OlexiyOdarchuk/ajax-final-project/case/expansion_board.step

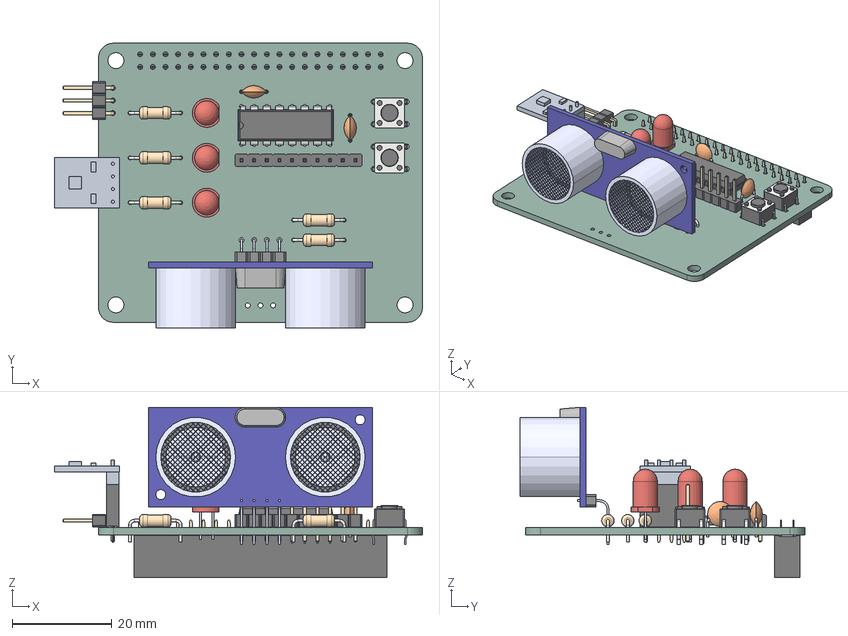
[picture p1: CAD file, 2026-10-27]
case/expansion_board.step
73.8 x 57.1 x 34.2 mm
R_Axial_DIN0207_L63mm_D25mm_P1016mm_Horizontal x 5
SW_PUSH_6mm x 2
LED_D5.0mm x 3
PinHeader_1x10_P254mm_Vertical
C_Disc_D50mm_W25mm_P500mm x 2
PinSocket_1x04_P2.54mm_Vertical
DIP-16_W7.62mm
HC-SR04
PinHeader_1x03_P254mm_Horizontal
PinSocket_2x20_P2.54mm_Vertical
rpi_PCB
