OlexiyOdarchuk/ajax-final-project/case/stl/case_lid.stl

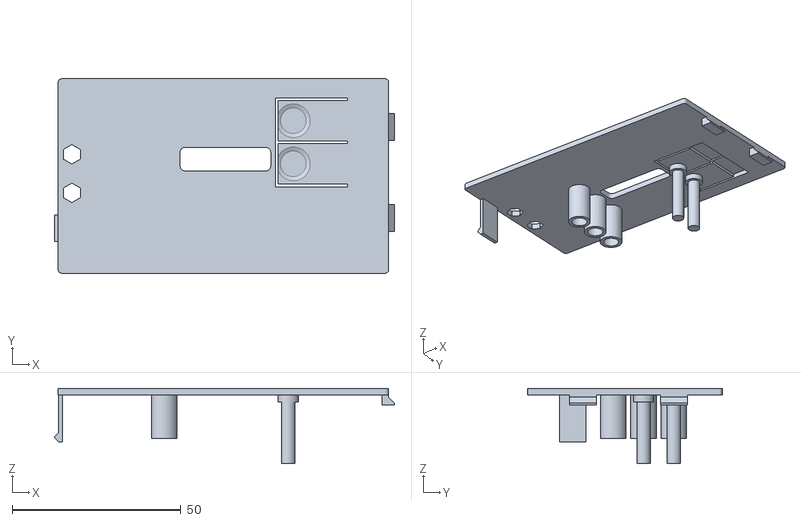
[picture p2: CAD file, 2026-10-06]
case/stl/case_lid.stl
100.9 x 57.7 x 22.4
