OlexiyOdarchuk/ajax-final-project/case/gateway_case.FCStd

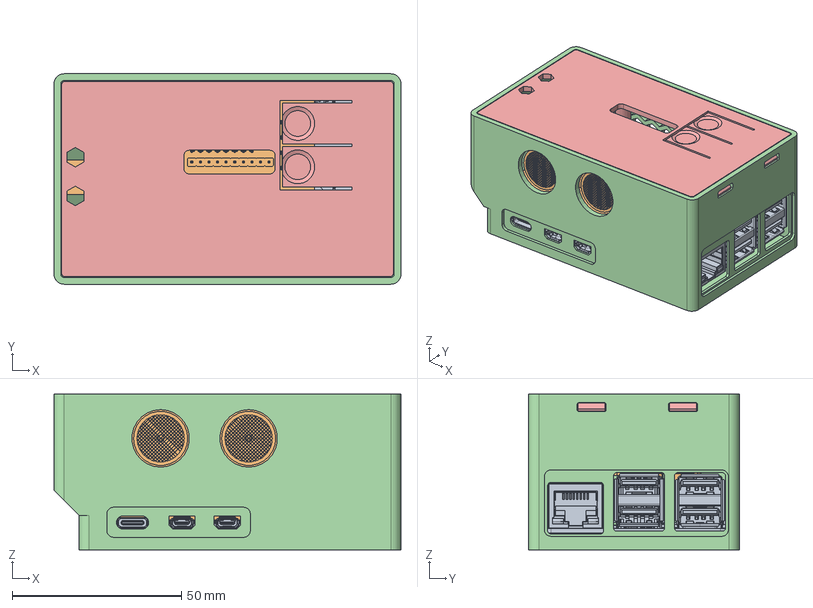
[picture p3: CAD file, 2026-10-27]
case/gateway_case.FCStd
102.5 x 62.2 x 46.0 mm
RaspberryPi5
ExpansionBoard
Standoffs
CaseBody
CaseLid
