OlexiyOdarchuk/ajax-final-project/case/stl/case_body.stl

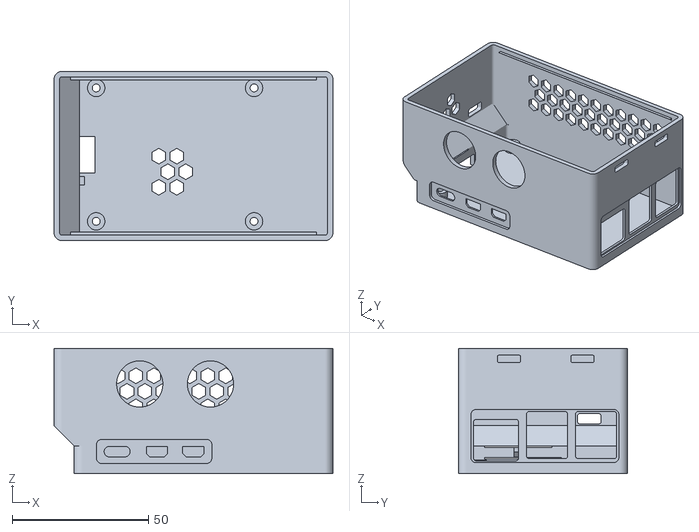
[picture p4: CAD file, 2026-10-06]
case/stl/case_body.stl
102.5 x 62.2 x 46.0
