OlexiyOdarchuk/ajax-final-project/expansion_board/rpi.kicad_pcb

## KiCad design expansion_board/rpi.kicad_pcb (2026-10-27)

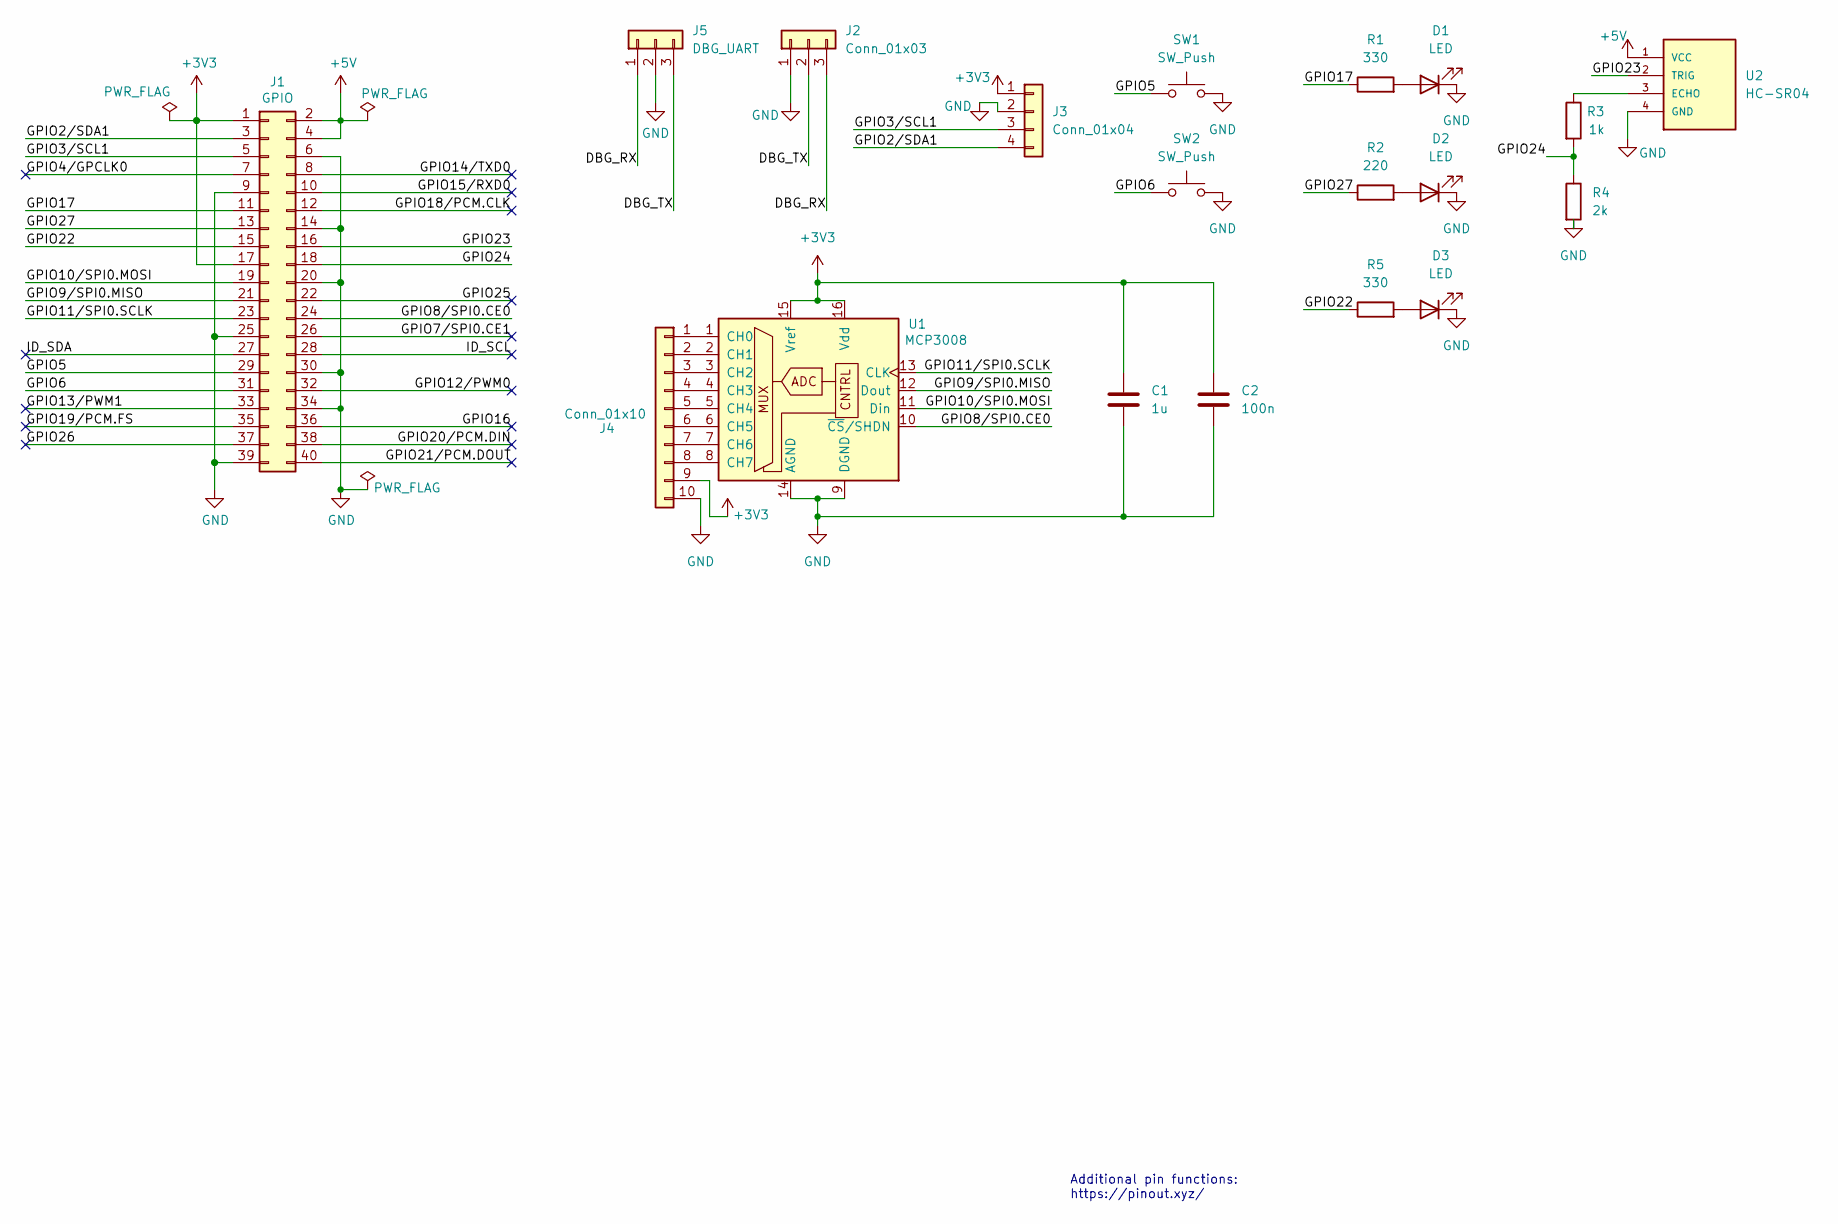
[picture p5: schematic rpi.kicad_sch]

Parts:
C1: 1u; C_Disc_D5.0mm_W2.5mm_P5.00mm
C2: 100n; C_Disc_D5.0mm_W2.5mm_P5.00mm
D1, D2, D3: LED; LED_D5.0mm
J1: GPIO; PinSocket_2x20_P2.54mm_Vertical
J2: Conn_01x03; PinHeader_1x03_P2.54mm_Horizontal
J3: Conn_01x04; PinSocket_1x04_P2.54mm_Vertical
J4: Conn_01x10; PinHeader_1x10_P2.54mm_Vertical
J5: DBG_UART; PinHeader_1x03_P2.54mm_Vertical
R1, R5: 330; R_Axial_DIN0207_L6.3mm_D2.5mm_P10.16mm_Horizontal
R2: 220; R_Axial_DIN0207_L6.3mm_D2.5mm_P10.16mm_Horizontal
R3: 1k; R_Axial_DIN0207_L6.3mm_D2.5mm_P10.16mm_Horizontal
R4: 2k; R_Axial_DIN0207_L6.3mm_D2.5mm_P10.16mm_Horizontal
SW1, SW2: SW_Push; SW_PUSH_6mm
U1: MCP3008; DIP-16_W7.62mm
U2: HC-SR04; XCVR_HC-SR04

Connections:
+3V3: C1.1, C2.1, J1.1, J1.17, J3.1, J4.9, U1.15 (Vref), U1.16 (Vdd)
+5V: J1.2, J1.4, U2.1 (VCC)
/DBG_RX: J2.3, J5.1
/DBG_TX: J2.2, J5.3
/GPIO2/SDA1: J1.3, J3.4
/GPIO3/SCL1: J1.5, J3.3
/GPIO4/GPCLK0: J1.7
/GPIO5: J1.29, SW1.1
/GPIO6: J1.31, SW2.1
/GPIO7/SPI0.CE1: J1.26
/GPIO8/SPI0.CE0: J1.24, U1.10 (~CS/SHDN)
/GPIO9/SPI0.MISO: J1.21, U1.12 (Dout)
/GPIO10/SPI0.MOSI: J1.19, U1.11 (Din)
/GPIO11/SPI0.SCLK: J1.23, U1.13 (CLK)
/GPIO12/PWM0: J1.32
/GPIO13/PWM1: J1.33
/GPIO14/TXD0: J1.8
/GPIO15/RXD0: J1.10
/GPIO16: J1.36
/GPIO17: J1.11, R1.1
/GPIO18/PCM.CLK: J1.12
/GPIO19/PCM.FS: J1.35
/GPIO20/PCM.DIN: J1.38
/GPIO21/PCM.DOUT: J1.40
/GPIO22: J1.15, R5.1
/GPIO23: J1.16, U2.2 (TRIG)
/GPIO24: J1.18, R3.2, R4.1
/GPIO25: J1.22
/GPIO26: J1.37
/GPIO27: J1.13, R2.1
/ID_SCL: J1.28
/ID_SDA: J1.27
GND: C1.2, C2.2, D1.1 (K), D2.1 (K), D3.1 (K), J1.6, J1.9, J1.14, J1.20, J1.25, J1.30, J1.34, J1.39, J2.1, J3.2, J4.10, J5.2, R4.2, SW1.2, SW2.2, U1.9 (DGND), U1.14 (AGND), U2.4 (GND)
unnamed: D1.2 (A), R1.2
unnamed: D2.2 (A), R2.2
unnamed: D3.2 (A), R5.2
unnamed: J4.1, U1.1 (CH0)
unnamed: J4.2, U1.2 (CH1)
unnamed: J4.3, U1.3 (CH2)
unnamed: J4.4, U1.4 (CH3)
unnamed: J4.5, U1.5 (CH4)
unnamed: J4.6, U1.6 (CH5)
unnamed: J4.7, U1.7 (CH6)
unnamed: J4.8, U1.8 (CH7)
unnamed: R3.1, U2.3 (ECHO)

Notes on the sheet:
Additional pin functions: https://pinout.xyz/

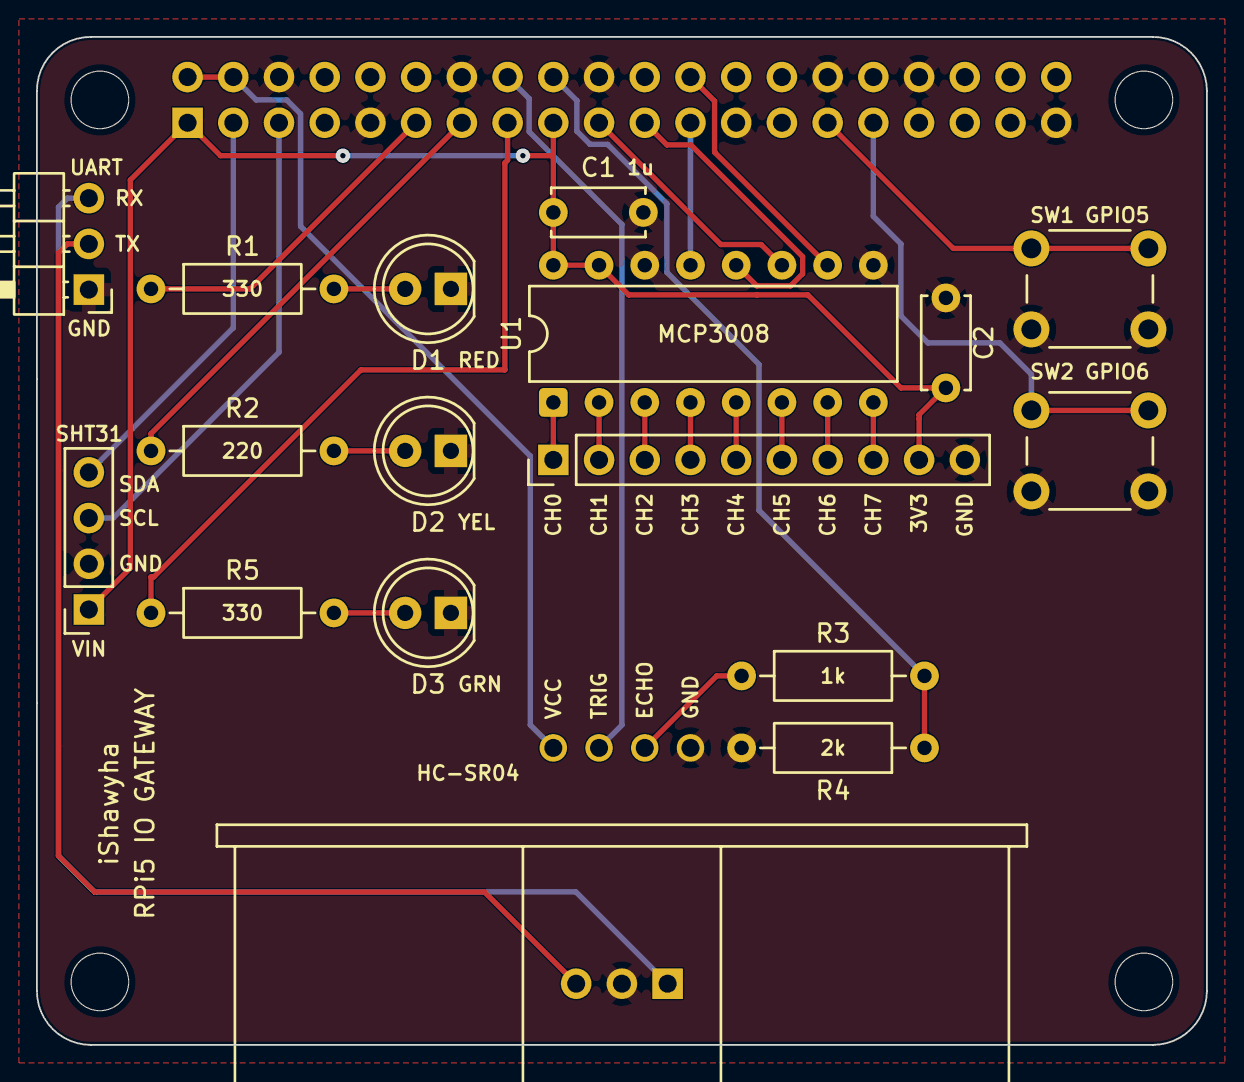
[picture p6: board rpi.kicad_pcb from above]

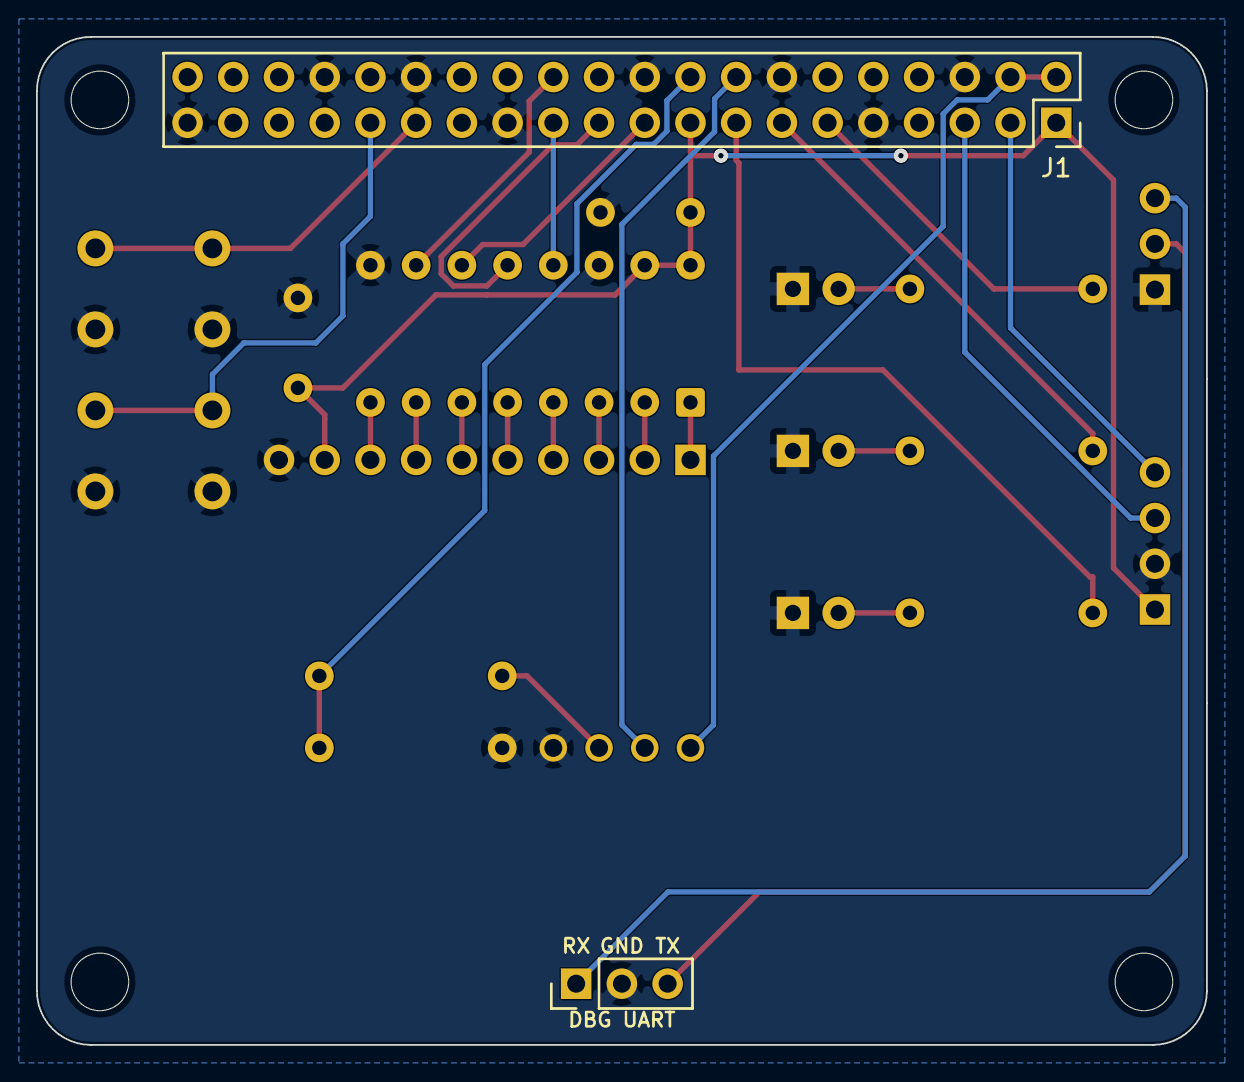
[picture p7: board rpi.kicad_pcb from below]

Board: 2 copper layers, 65.0 x 56.0 mm, 23 parts (2 on the bottom side), 30 nets.

Other parts of the board:
MH1, MH2, MH3, MH4: MountingHole_3.2mm
