OlexiyOdarchuk/ajax-final-project/(commit log)

2026-10-06 init repo with case and expansion_board
    [case_body.stl, case_lid.stl, expansion_board.step, gateway_case.FCStd, rpi.kicad_pcb, rpi.kicad_sch]
2026-10-06 Update silkscreen and 3v3 link
    [rpi.kicad_pcb]
2026-10-07 Change capasitor to 1uF from datasheet
    [rpi.kicad_pcb, rpi.kicad_sch]
2026-10-09 Update UART for native port on RPI
    [rpi.kicad_pcb, rpi.kicad_sch]
2026-10-26 Prepare PCB for fabrication: 0.15mm silkscreen, 1.0mm HC-SR04 drills; ignore production output
2026-10-27 Make project self-contained: local rpi symbol/footprint/3D libs, C2 decoupling, ERC/DRC clean
    - Move all symbols, footprints (taken from the board) and STEP models into libs/rpi.*
    - Route C2 (100n on +3V3 at J4)
    - Fix no-connect flags on unused RPi header pins
    - Exclude silkscreen-over-edge warnings for overhanging HC-SR04 and J2
2026-10-27 Normalize DRC exclusions order as written by KiCad
2026-10-27 Drop J5 pin header model (debug UART wires solder directly), refresh case board STEP
2026-10-27 C2 silkscreen 0.15mm to meet pcb24 minimum
2026-10-27 Fix C2 shorting GPIO6, 3.2 mm mounting holes with 0.5 mm copper keepout, 0.8 mm vias; refresh case STEP
    - Reroute GPIO6 on B.Cu between C2 pads, move C2 reference off U1, drop dangling stubs
    - MountingHole_3.2mm replaces the 2.7 mm footprint on all four holes
    - +3V3 vias 0.6 -> 0.8 mm so the annular ring survives pcb24 drill tolerance
